titio72/n2k_wind/WindPCB ADC/fabrication/WindPCB_BOM.csv

Designator | Value | Footprint | Quantity | MPN | Manufacturer
C1, C3, C4, C5, C7, C10, C11 | 100nF | Capacitor_SMD:C_0805_2012Metric | 7 | CC0805KRX7R9BB104 | Yageo
C2 | 1uF | Capacitor_SMD:C_0805_2012Metric | 1 | CC0805KRX7R7BB105 | Yageo
C6 | 330uF 25V | Capacitor_SMD:CP_Elec_8x10 | 1 | EEE-FK1E331P | Panasonic
C8 | 22nF | Capacitor_SMD:C_0805_2012Metric | 1 | CC0805KRX7R9BB223 | Yageo
C9 | 10uF | Capacitor_Tantalum_SMD:CP_EIA-3216-18_Kemet-A | 1 | T491A106K010AT | Kemet
C12 | 10uF | Capacitor_SMD:C_0805_2012Metric | 1 | CL21A106KOQNNNE | Samsung Electro-Mechanics
D1 | LED_RED | LED_SMD:LED_0805_2012Metric | 1 | 150080RS75000 | Wurth Elektronik
D2 | NUP2105L | Package_TO_SOT_SMD:SOT-23 | 1 | NUP2105LT1G | onsemi
F1 | 250mA | Fuse:Fuse_Littelfuse-NANO2-451_453 | 1 | 0454.250MR | Littelfuse
R1 | 3K3 | Resistor_SMD:R_0805_2012Metric | 1 | RC0805FR-073K3L | Yageo
R2, R3, R5, R6, R8 | 4K7 | Resistor_SMD:R_0805_2012Metric | 5 | RC0805FR-074K7L | Yageo
R4 | 220 | Resistor_SMD:R_0805_2012Metric | 1 | RC0805FR-07220RL | Yageo
R7 | 120 | Resistor_SMD:R_0805_2012Metric | 1 | RC0805FR-07120RL | Yageo
R9 | 10K | Resistor_SMD:R_0805_2012Metric | 1 | RC0805FR-0710KL | Yageo
R12 | 2K2 | Resistor_SMD:R_0805_2012Metric | 1 | RC0805FR-072K2L | Yageo
U1 | 74AHC1G14 | Package_TO_SOT_SMD:SOT-23-5_HandSoldering | 1 | SN74AHC1G14DBVR | Texas Instruments
U2 | MCP2562-E-SN | Package_SO:SOIC-8_3.9x4.9mm_P1.27mm | 1 | MCP2562-E/SN | Microchip
U5 | UA78M05CDCYR | Package_TO_SOT_SMD:SOT-223-3_TabPin2 | 1 | UA78M05CDCYR | Texas Instruments
U6 | UA78M08CDCYR | Package_TO_SOT_SMD:SOT-223-3_TabPin2 | 1 | UA78M08CDCYR | Texas Instruments
U7 | MCP3202 | Package_SO:SOIC-8_3.9x4.9mm_P1.27mm | 1 | MCP3202-CI/SN | Microchip
U9, U10, U11 | LM66100DCK | Package_TO_SOT_SMD:SOT-363_SC-70-6 | 3 | LM66100DCKR | Texas Instruments
