titio72/n2k_wind/WindPCB ADC/WindPCB.kicad_pcb

## KiCad design WindPCB ADC/WindPCB.kicad_pcb (2026-11-12)

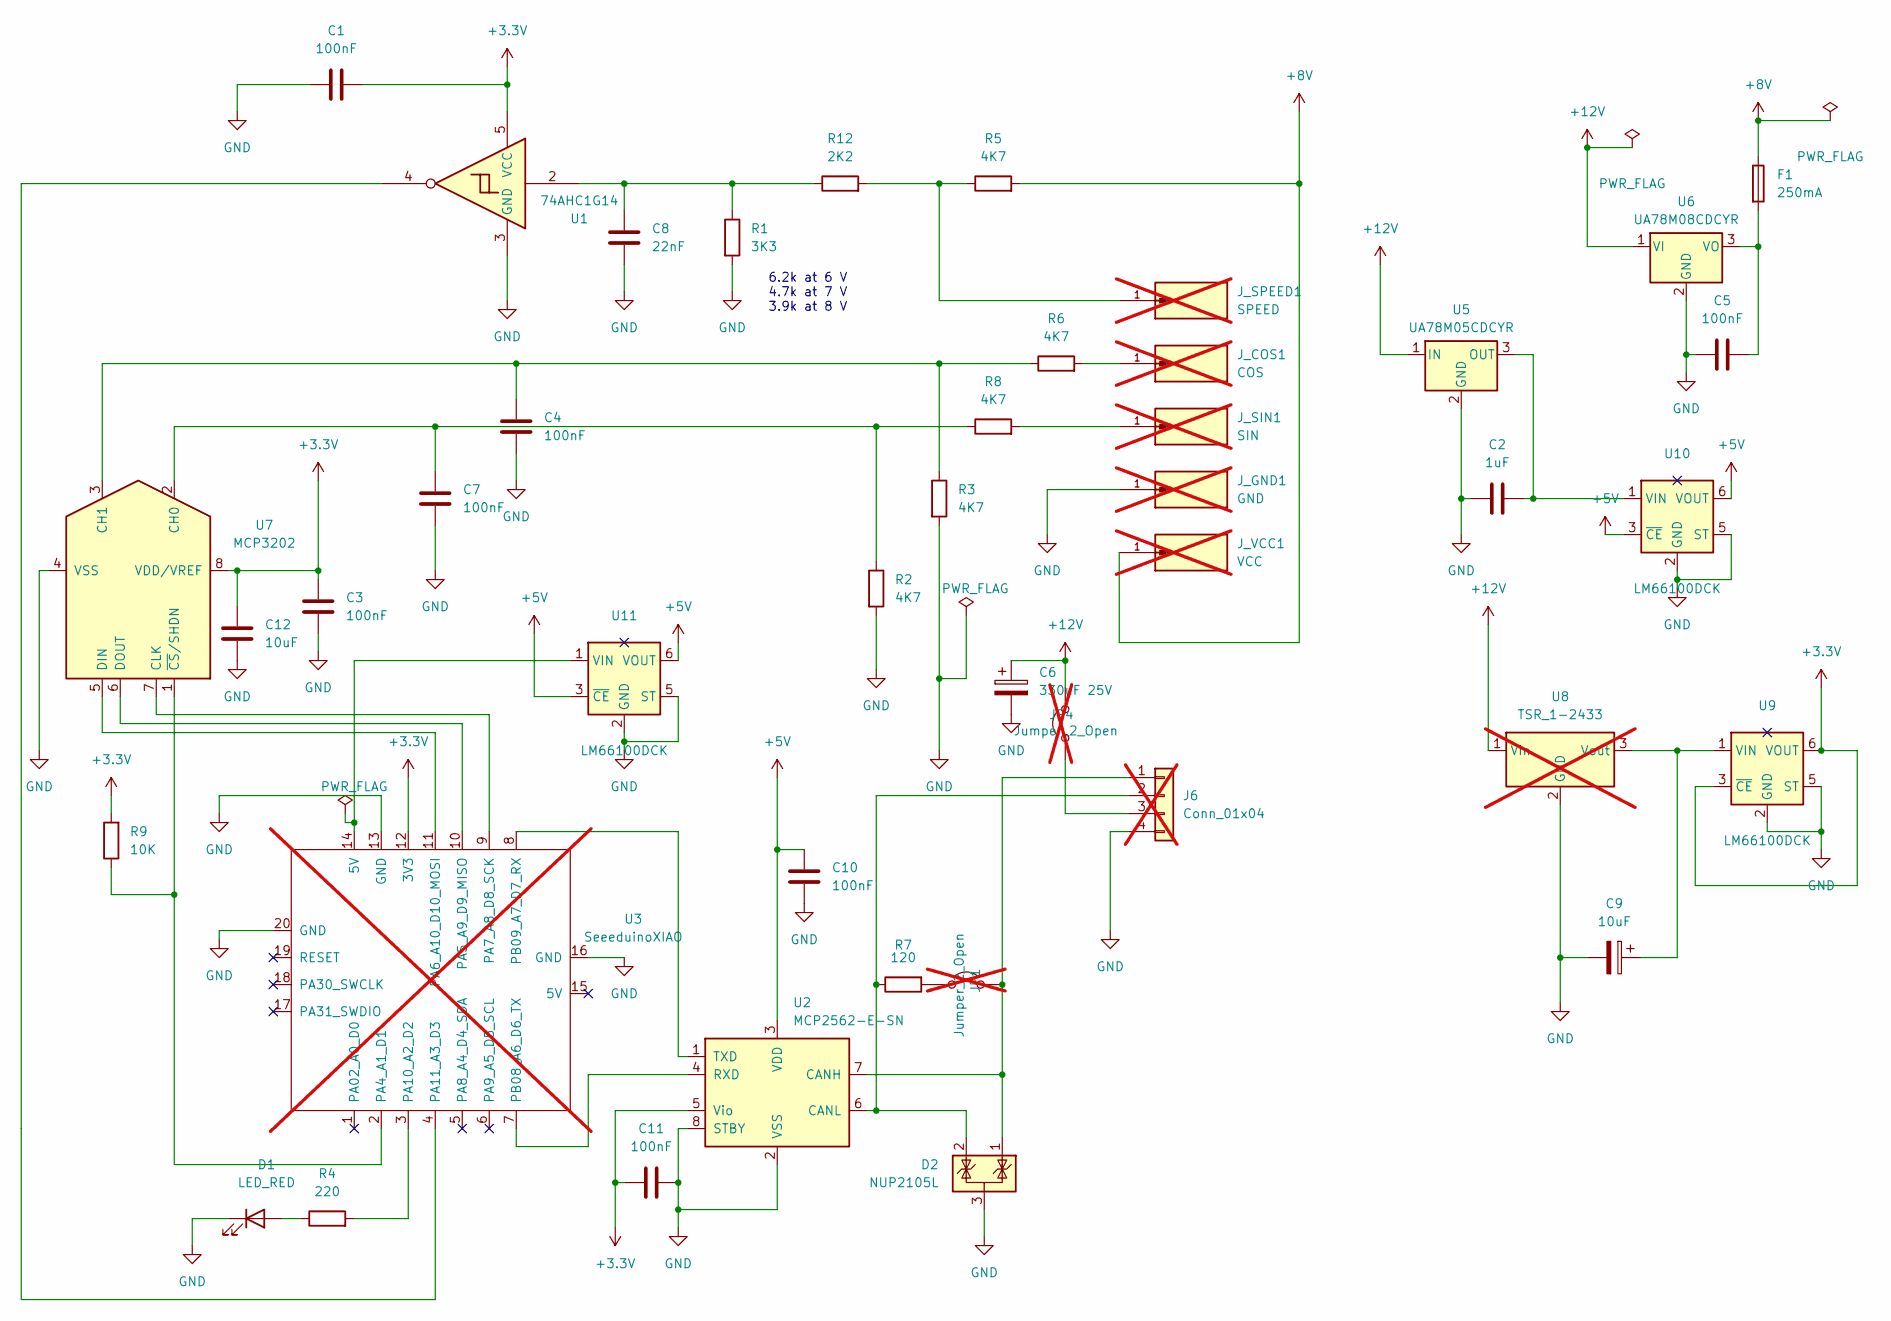
[picture p1: schematic WindPCB.kicad_sch]

Parts:
C1, C3, C4, C5, C7, C10, C11: 100nF; C_0805_2012Metric; MPN CC0805KRX7R9BB104
C2: 1uF; C_0805_2012Metric; MPN CC0805KRX7R7BB105
C6: 330uF 25V; CP_Elec_8x10; MPN EEE-FK1E331P
C8: 22nF; C_0805_2012Metric; MPN CC0805KRX7R9BB223
C9: 10uF; CP_EIA-3216-18_Kemet-A; MPN T491A106K010AT
C12: 10uF; C_0805_2012Metric; MPN CL21A106KOQNNNE
D1: LED_RED; LED_0805_2012Metric; MPN 150080RS75000
D2: NUP2105L; SOT-23; MPN NUP2105LT1G
F1: 250mA; Fuse_Littelfuse-NANO2-451_453; MPN 0454.250MR
J6: Conn_01x04; JST_EH_B4B-EH-A_1x04_P2.50mm_Vertical; not fitted
JP1, JP4: Jumper_2_Open; PinHeader_1x02_P2.54mm_Vertical; not fitted
J_COS1: COS; KEYSTONE_1267; PARTREV D; not fitted
J_GND1: GND; KEYSTONE_1267; PARTREV D; not fitted
J_SIN1: SIN; KEYSTONE_1267; PARTREV D; not fitted
J_SPEED1: SPEED; KEYSTONE_1267; PARTREV D; not fitted
J_VCC1: VCC; KEYSTONE_1267; PARTREV D; not fitted
R1: 3K3; R_0805_2012Metric; MPN RC0805FR-073K3L
R2, R3, R5, R6, R8: 4K7; R_0805_2012Metric; MPN RC0805FR-074K7L
R4: 220; R_0805_2012Metric; MPN RC0805FR-07220RL
R7: 120; R_0805_2012Metric; MPN RC0805FR-07120RL
R9: 10K; R_0805_2012Metric; MPN RC0805FR-0710KL
R12: 2K2; R_0805_2012Metric; MPN RC0805FR-072K2L
U1: 74AHC1G14; SOT-23-5_HandSoldering; MPN SN74AHC1G14DBVR
U2: MCP2562-E-SN; SOIC-8_3.9x4.9mm_P1.27mm; MPN MCP2562-E/SN
U3: SeeeduinoXIAO; Seeeduino XIAO-MOUDLE14P-2.54-21X17.8MM_1; not fitted
U5: UA78M05CDCYR; SOT-223-3_TabPin2; MPN UA78M05CDCYR
U6: UA78M08CDCYR; SOT-223-3_TabPin2; MPN UA78M08CDCYR
U7: MCP3202; SOIC-8_3.9x4.9mm_P1.27mm; MPN MCP3202-CI/SN
U8: TSR_1-2433; Converter_DCDC_TRACO_TSR-1_THT; MPN TSR 1-2433; not fitted
U9, U10, U11: LM66100DCK; SOT-363_SC-70-6; MPN LM66100DCKR

Connections:
+3.3V: C1.1, C3.1, C11.1, C12.1, R9.2, U1.5 (VCC), U2.5 (Vio), U3.12 (3V3), U7.8 (VDD/VREF), U9.3 (~CE), U9.6 (VOUT)
+5V: C10.1, U2.3 (VDD), U10.3 (~CE), U10.6 (VOUT), U11.3 (~CE), U11.6 (VOUT)
+8V: F1.1, J_VCC1.1, R5.2
+12V: C6.1, JP4.2 (B), U5.1 (IN), U6.1 (VI), U8.1 (Vin)
GND: C1.2, C2.1, C3.2, C4.2, C5.1, C6.2, C7.2, C8.2, C9.2, C10.2, C11.2, C12.2, D1.1 (K), D2.3 (A), J6.4, J_GND1.1, R1.2, R2.2, R3.2, U1.3 (GND), U2.2 (VSS), U2.8 (STBY), U3.13 (GND), U3.16 (GND), U3.20 (GND), U5.2 (GND), U6.2 (GND), U7.4 (VSS), U8.2 (GND), U9.2 (GND), U9.5 (ST), U10.2 (GND), U10.5 (ST), U11.2 (GND), U11.5 (ST)
unnamed: C8.1, R1.1, R12.1, U1.2
unnamed: D1.2 (A), R4.1
unnamed: D2.1 (K), J6.1, JP1.2 (B), U2.7 (CANH)
unnamed: D2.2 (K), J6.2, R7.1, U2.6 (CANL)
unnamed: J6.3, JP4.1 (A)
unnamed: JP1.1 (A), R7.2
unnamed: J_COS1.1, R6.2
unnamed: J_SIN1.1, R8.2
unnamed: J_SPEED1.1, R5.1, R12.2
unnamed: U2.4 (RXD), U3.7 (PB08_A6_D6_TX)
unnamed: U2.1 (TXD), U3.8 (PB09_A7_D7_RX)
unnamed: R9.1, U3.2 (PA4_A1_D1), U7.1 (~CS/SHDN)
unnamed: U3.10 (PA5_A9_D9_MISO), U7.6 (DOUT)
unnamed: U3.11 (PA6_A10_D10_MOSI), U7.5 (DIN)
unnamed: U3.9 (PA7_A8_D8_SCK), U7.7 (CLK)
unnamed: R4.2, U3.3 (PA10_A2_D2)
unnamed: U1.4, U3.4 (PA11_A3_D3)
unnamed: C5.2, F1.2, U6.3 (VO)
unnamed: C7.1, R2.1, R8.1, U7.2 (CH0)
unnamed: C4.1, R3.1, R6.1, U7.3 (CH1)
unnamed: C9.1, U8.3 (Vout), U9.1 (VIN)
unnamed: C2.2, U5.3 (OUT), U10.1 (VIN)
unnamed: U3.14 (5V), U11.1 (VIN)

Notes on the sheet:
6.2k at 6 V 4.7k at 7 V 3.9k at 8 V

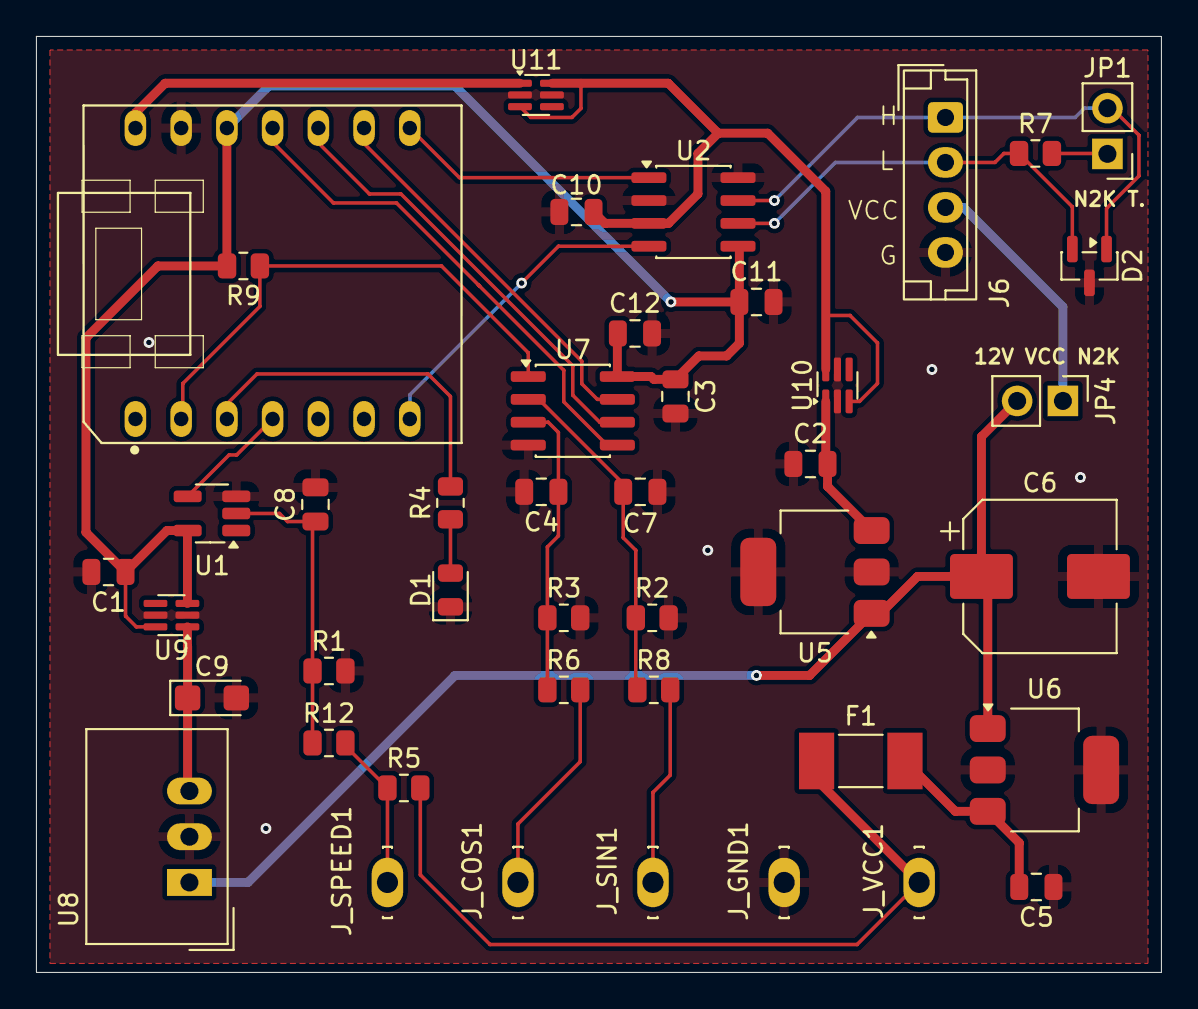
[picture p2: board WindPCB ADC/WindPCB.kicad_pcb from above]

Board: 2 copper layers, 62.5 x 52.0 mm, 43 parts (0 on the bottom side), 28 nets.
