titio72/n2k_wind/WindPCB/WindPCB.kicad_pcb

## KiCad design WindPCB/WindPCB.kicad_pcb (2026-10-11)

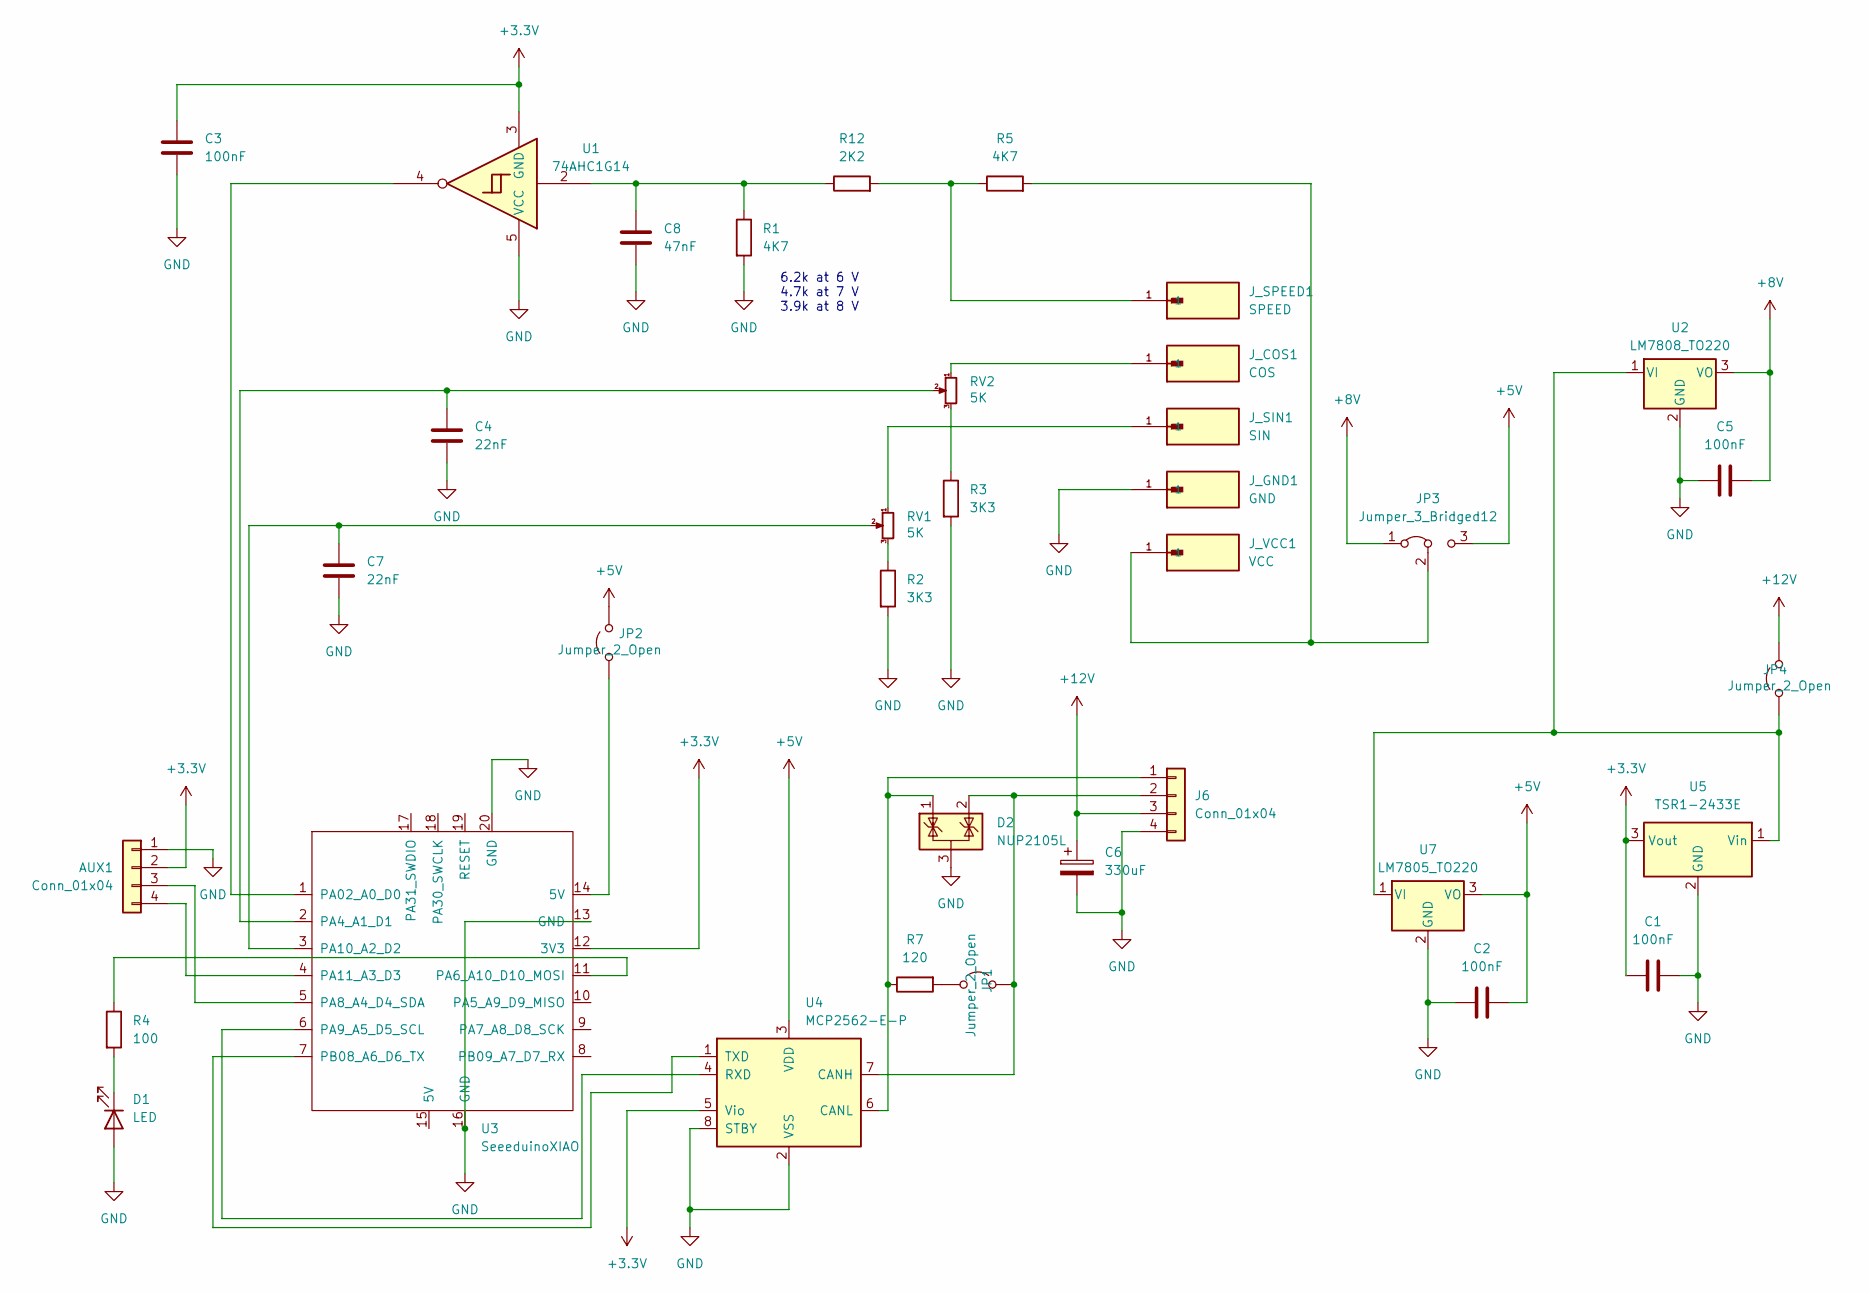
[picture p3: schematic WindPCB.kicad_sch]

Parts:
AUX1: Conn_01x04; JST_EH_B4B-EH-A_1x04_P2.50mm_Vertical
C1, C2, C3, C5: 100nF; C_Disc_D6.0mm_W2.5mm_P5.00mm
C4, C7: 22nF; C_Disc_D6.0mm_W2.5mm_P5.00mm
C6: 330uF; CP_Radial_D6.3mm_P2.50mm
C8: 47nF; C_Disc_D6.0mm_W2.5mm_P5.00mm
D1: LED; LED_D3.0mm
D2: NUP2105L; SOT-23
J6: Conn_01x04; JST_EH_B4B-EH-A_1x04_P2.50mm_Vertical
JP1, JP2, JP4: Jumper_2_Open; PinHeader_1x02_P2.54mm_Vertical
JP3: Jumper_3_Bridged12; PinHeader_1x03_P2.54mm_Vertical
J_COS1: COS; KEYSTONE_1267; PARTREV D
J_GND1: GND; KEYSTONE_1267; PARTREV D
J_SIN1: SIN; KEYSTONE_1267; PARTREV D
J_SPEED1: SPEED; KEYSTONE_1267; PARTREV D
J_VCC1: VCC; KEYSTONE_1267; PARTREV D
R1, R5: 4K7; R_Axial_DIN0204_L3.6mm_D1.6mm_P7.62mm_Horizontal
R2, R3: 3K3; R_Axial_DIN0204_L3.6mm_D1.6mm_P7.62mm_Horizontal
R4: 100; R_Axial_DIN0204_L3.6mm_D1.6mm_P7.62mm_Horizontal
R7: 120; R_Axial_DIN0204_L3.6mm_D1.6mm_P7.62mm_Horizontal
R12: 2K2; R_Axial_DIN0204_L3.6mm_D1.6mm_P7.62mm_Horizontal
RV1, RV2: 5K; Potentiometer_Bourns_3296W_Vertical
U1: 74AHC1G14; SOT-23-5_HandSoldering
U2: LM7808_TO220; TO-220-3_Vertical
U3: SeeeduinoXIAO; Seeeduino XIAO-MOUDLE14P-2.54-21X17.8MM_1
U4: MCP2562-E-P; DIP-8_W7.62mm
U5: TSR1-2433E; Converter_DCDC_TRACO_TSR-1_THT
U7: LM7805_TO220; TO-220-3_Vertical

Connections:
+3.3V: AUX1.2, C1.2, C3.1, U1.3 (GND), U3.12 (3V3), U4.5 (Vio), U5.3 (Vout)
+5V: C2.1, JP2.2 (B), JP3.3 (B), U4.3 (VDD), U7.3 (VO)
+8V: C5.1, JP3.1 (A), U2.3 (VO)
+12V: C6.1, J6.3, JP4.2 (B)
GND: AUX1.1, C1.1, C2.2, C3.2, C4.2, C5.2, C6.2, C7.2, C8.2, D1.2 (A), D2.3 (A), J6.4, J_GND1.1, R1.2, R2.2, R3.2, U1.5 (VCC), U2.2 (GND), U3.13 (GND), U3.16 (GND), U3.20 (GND), U4.2 (VSS), U4.8 (STBY), U5.2 (GND), U7.2 (GND)
unnamed: AUX1.3, U3.5 (PA8_A4_D4_SDA)
unnamed: AUX1.4, U3.4 (PA11_A3_D3)
unnamed: C8.1, R1.1, R12.1, U1.2
unnamed: D1.1 (K), R4.2
unnamed: D2.1 (K), J6.1, R7.1, U4.6 (CANL)
unnamed: D2.2 (K), J6.2, JP1.2 (B), U4.7 (CANH)
unnamed: JP1.1 (A), R7.2
unnamed: JP2.1 (A), U3.14 (5V)
unnamed: JP3.2 (C), J_VCC1.1, R5.2
unnamed: JP4.1 (A), U2.1 (VI), U5.1 (Vin), U7.1 (VI)
unnamed: J_COS1.1, RV2.1
unnamed: J_SIN1.1, RV1.1
unnamed: J_SPEED1.1, R5.1, R12.2
unnamed: R2.1, RV1.3
unnamed: R3.1, RV2.3
unnamed: U1.4, U3.1 (PA02_A0_D0)
unnamed: C4.1, RV2.2, U3.2 (PA4_A1_D1)
unnamed: R4.1, U3.11 (PA6_A10_D10_MOSI)
unnamed: U3.6 (PA9_A5_D5_SCL), U4.4 (RXD)
unnamed: C7.1, RV1.2, U3.3 (PA10_A2_D2)
unnamed: U3.7 (PB08_A6_D6_TX), U4.1 (TXD)

Notes on the sheet:
6.2k at 6 V 4.7k at 7 V 3.9k at 8 V

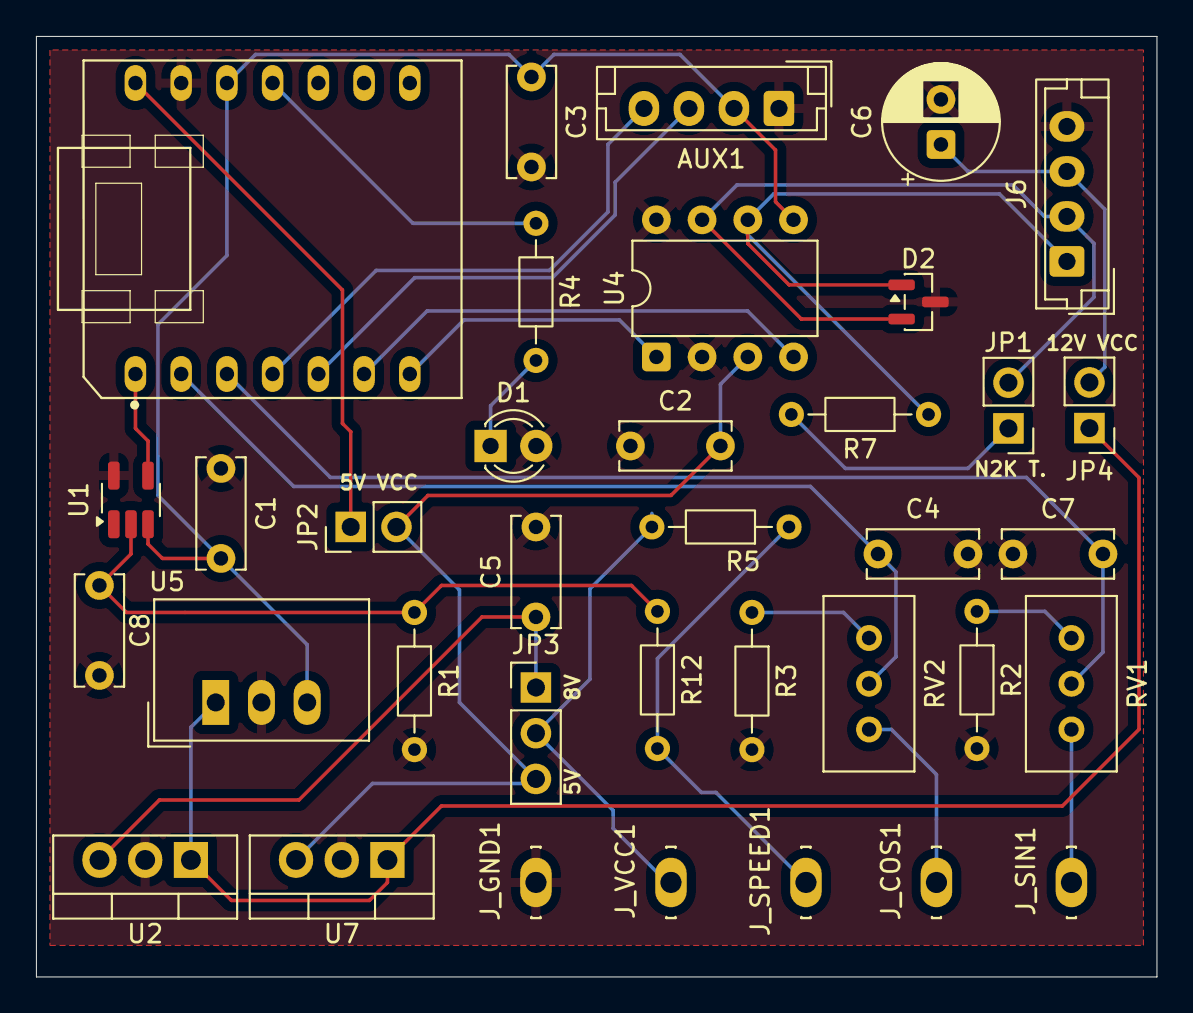
[picture p4: board WindPCB/WindPCB.kicad_pcb from above]

Board: 2 copper layers, 62.2 x 52.2 mm, 36 parts (0 on the bottom side), 26 nets.
