titio72/n2k_wind/src/Constants.h

#ifndef _CONSTANTS_H
#define _CONSTANTS_H

// 12 bit ADC for ESP32, 16 bit ADC for ADS1115
#define MIN_ADC_VALUE 400  // with a power supply of 8V, raymarine specs inidcate a range of 2V-6V, so 400/4096*8V=0.78V is a reasonable threshold
#define MAX_ADC_VALUE 4095
#define MAX_ADC_RANGE 4096 // 12 bit ADC
#define RANGE_DEFAULT_MIN 1024 // default Raymarine specs: 2V over 8V span
#define RANGE_DEFAULT_MAX 3072 // default Raymarine specs: 6V over 8V span
#define RANGE_DEFAULT_VALID 1024 // minimum span to consider a range valid

const uint8_t WIND_ERROR_OFF_CALIBRATION = 0x02; // (bit #1)
const uint8_t WIND_ERROR_NO_SIGNAL = 0x01; // (bit #0)
const uint8_t WIND_ERROR_OK = 0x00;

const uint8_t STW_ERROR_NO_SIGNAL = 0x01; // (bit #0)
const uint8_t STW_ERROR_OK = 0x00;

const uint8_t TEMP_ERROR_NO_SIGNAL = 0x01; // (bit #0)
const uint8_t TEMP_ERROR_OK = 0x00;

#define DEFAULT_WIND_SPEED_SMOOTHING 50 // %
#define DEFAULT_WIND_ANGLE_SMOOTHING 50 // %
#define DEFAULT_STW_SMOOTHING 50 // %
#define DEFAULT_TEMP_SMOOTHING 50 // %

#ifndef DEFAULT_N2K_SOURCE
#define DEFAULT_N2K_SOURCE 21
#endif
#define N2K_MODEL_SERIAL_CODE "0.0.1"
#define N2K_PRODUCT_CODE 101
#define N2K_MODEL_ID "ABWind"
#define N2K_SW_CODE "0.0.1"
#define N2K_MODEL_VERSION "0001"
#define N2K_UNIQUE_NUMBER 2
#define N2K_DEVICEE_FUNCTION 180
#define N2K_DEVICE_CLASS 60
#define N2K_MANIFACTURER_CODE 2046 // just one available...

/*
On ST50:
The vane are r=55mm from the center, so a full round is 2*pi*r
With a frequency of f HZ (there are 4 magnets, so 2 transitions per round, hence the round per seconds are f/2),
it makes a total distance of L=(f/2)*2*pi*r in 1 second, hence the speed in knots is L*3600/1852.
This is assuming that there is no friction - let's assume that the rotation speed is 50% of.
The magic number to convert Hz in Knots is 2*(pi*0.055*2600/1852) = 0.672

On ST60 
Raymarine says that 20Hz (10Hz considering a full revolution) is 20Knots, which would mean a factor of 1.0 instead of 0.672
*/
#define VANE_TYPE_ST50 0
#define VANE_TYPE_ST60 1

#define VANE_TYPE_DEFAULT VANE_TYPE_ST50 // ST50

#define HZ_TO_KNOTS_ST50 0.700 // use 0.673 ~ 0.700 for ST50
#define HZ_TO_KNOTS_ST60 1.000 // use 1.000 for ST60

// Sin and Cos are calculated as moving average over N samples
#define SIN_COS_BUFFER_SIZE 200 // about 0.2s averaging at 1ms rate 

// main loop
#define MAIN_LOOP_PERIOD_LOW_FREQ 250L // (millis) regulates the main loop used to read sensors and interacts with N2K & BLE
#define WIND_N2K_DATA_FREQ 500L // (millis) regulates how frequently send out wind info on the N2K bus
#define STW_N2K_DATA_FREQ 1000L // (millis) regulates how frequently send out speed through water info on the N2K bus
#define CORRECTION_TABLE_FIRST_BROADCAST 5000L // (millis) first PGN 130900 broadcast after boot
#define CORRECTION_TABLE_BROADCAST_PERIOD 60000L // (millis) PGN 130900 repeat period
#define CALIBRATION_SAMPLING_EXCLUSION_PERIOD 10000L // (millis) do not take samples for 10 seconds after restart (sample would be funny)
#define CPU_FREQUENCY 80 // MHz (ESP32 default is 160). 80 is the lower value that makes the device operable
#define SPEED_SENSING_PERIOD_MULTIPLIER 4 // The frequency is collected every N main loops to reduce noise (1 means every loop, 2 every two loops, etc...)

// BLE
#define BLE_DEVICE_UUID "32890585-c6ee-498b-9e7a-044baefb6542"
#define BLE_COMMAND_UUID "c3fe2075-ac6c-40bf-8073-73a110453725"
#define BLE_CONF_UUID "c04a9b9c-3ab6-4cce-9b59-1b582112e693"
#define BLE_WIND_DATA_UUID "003d0cab-70f7-43ac-8ab9-db26466572af"
// Correction table, PGN 130900 payload (10..180 bytes). Read it (long read):
// a notification is cut at MTU-3 = 125 bytes, so don't subscribe.
#define BLE_TABLE_UUID "b0ff19bd-7c2d-4215-8cc0-2a6db52cdf4f"
#define BLE_DEVICE_NAME "Wind"
#define BLE_COMMAND_CHARACTERISTIC_NAME "command"
#define BLE_DATA_CHARACTERISTIC_NAME "data"
#define BLE_CONF_CHARACTERISTIC_NAME "conf"
#define BLE_TABLE_CHARACTERISTIC_NAME "table"
#define BLE_ACTIVITY_TIMEOUT 30000L // (millis) time after which we consider that the connection is dead if no command is received

// The reading gives sin and cos, and sqrt(sin^2+cos^2 )must be equal to 1.0, or close to it. Large differences means that the linearization
// of the sin and cos sensors is off. This define the admissible delta, which essentially mesaure the eccentricity of measure.
#define ELLIPSE_VALIDITY_THRESHOLD 0.2

// admissible value ranges for configuration 
#define SMOOTHING_ALPHA_MIN 0
#define SMOOTHING_ALPHA_MAX 100

#define AUTO_CALIB_THRESHOLD_MIN 50
#define AUTO_CALIB_THRESHOLD_MAX 100
#define AUTO_CALIBRATION_SCORE_THRESHOLD_DEFAULT 0.75 // default threshold to consider a calibration valid

const uint8_t YES = 1;
const uint8_t NO = 0;
#endif
