titio72/n2k_wind/src/CommandHandler.cpp

#include <Log.h>
#include "CommandHandler.h"
#include "DataAndConf.h"
#include "Calibration.h"
#include "BLEWind.h"
#include "WindCorrection.h"
#include "CorrectionPersistence.h"
#include <stdlib.h>
#include <math.h>

struct CommandContext
{
    ConfPersistence &confPersistence;
    configuration &conf;
    Calibration &cal;
    IBLEWind &ble;
    correction_table &table;
    CorrectionPersistence &tablePersistence;
    table_changed_callback on_table_changed;

    bool write_conf()
    {
        return confPersistence.write(conf);
    }

    // Persists the edited copy; only then makes it the table and notifies.
    // On a write failure the table is left as it was.
    CommandResult commit_table(const correction_table &edited)
    {
        if (!tablePersistence.write(edited))
        {
            Log::trace("[CMD] Error writing correction table\n");
            return CommandResult::WRITE_ERROR;
        }
        table = edited;
        if (on_table_changed)
            on_table_changed();
        return CommandResult::SUCCESS;
    }
};

/*
The first char of the input is the "command", so there can be only 256 (plenty).
The following characters are a null terminated string and they contains the payload (if any).
Easy to parse and enough for the purpose.
*/
typedef CommandResult (*wind_command)(CommandContext &ctx, const char *command_value);
wind_command commands[256];

#pragma region commands
CommandResult apply_calibration(Range &sin, Range& cos, calibration_callback cback)
{
    if (cback && cback(sin, cos))
    {
        return CommandResult::SUCCESS;
    }
    else
    {
        Log::trace("[CMD] Manual calibration failed.\n");
        return CommandResult::INTERNAL_ERROR;
    }
}

CommandResult command_vane_type(CommandContext &ctx, const char* command_value)
{
    Log::trace("[CMD] Setting vane type {%s}\n", command_value);
    int32_t vane = 0;
    if (parse_value(vane, command_value, VANE_TYPE_ST60, VANE_TYPE_ST50))
    {
        Log::trace("[CMD] New vane type {%s}\n", vane==VANE_TYPE_ST50?"ST50":"ST60");
        ctx.conf.vane_type = vane;
        return ctx.write_conf() ? CommandResult::SUCCESS : CommandResult::WRITE_ERROR;
    }
    Log::trace("[CMD] Invalid vane type\n");
    return CommandResult::INVALID_FORMAT;
}

CommandResult command_heartbeat(CommandContext &ctx, const char* command_value)
{
    // do nothing
    return CommandResult::SUCCESS;
}

CommandResult command_set_speed_adj(CommandContext &ctx, const char *command_value)
{
    Log::trace("[CMD] Setting speed adjustment {%s}\n", command_value);
    int32_t adj = atoi(command_value);
    if (parse_value(adj, command_value, 255, 0))
    {
        Log::trace("[CMD] New speed adjustment {%d}\n", adj);
        ctx.conf.speed_adjustment = adj;
        return ctx.write_conf() ? CommandResult::SUCCESS : CommandResult::WRITE_ERROR;
    }
    Log::trace("[CMD] Invalid speed adjustment\n");
    return CommandResult::INVALID_FORMAT;
}

CommandResult command_set_offset(CommandContext &ctx, const char *command_value)
{
    Log::trace("[CMD] Setting offset {%s}\n", command_value);
    int32_t offset = 0;
    if (parse_value(offset, command_value, 360, -360))
    {
        Log::trace("[CMD] New offset {%d}\n", offset);
        ctx.conf.offset = offset;
        return ctx.write_conf() ? CommandResult::SUCCESS : CommandResult::WRITE_ERROR;
    }
    Log::trace("[CMD] Invalid offset\n");
    return CommandResult::INVALID_FORMAT;
}

CommandResult command_set_calibration(CommandContext &ctx, const char *command_value)
{
    Log::trace("[CMD] Setting manual calibration {%s}\n", command_value);
    int i_tok = 0;
    int32_t vv[] = {-1, -1, -1, -1};
    bool do_write = false;
    char s[256];
    strncpy(s, command_value, sizeof(s));
    char *t, *p;
    for (t = mystrtok(&p, s, '|'); t && i_tok < 4; t = mystrtok(&p, 0, '|'))
    {
        if (strlen(t))
        {
            parse_value(vv[i_tok], t, MAX_ADC_VALUE);
        }
        i_tok++;
    }
    Log::trace("[CMD] Read manual cal values {%d %d %d %d}\n", vv[0], vv[1], vv[2], vv[3]);
    if (vv[0] >= 0 && vv[1] >= 0 && vv[2] >= 0 && vv[3] >= 0)
    {
        Range s_range((uint16_t)vv[0], (uint16_t)vv[1], RANGE_DEFAULT_VALID);
        Range c_range((uint16_t)vv[2], (uint16_t)vv[3], RANGE_DEFAULT_VALID);
        return apply_calibration(s_range, c_range, ctx.cal.get_callback());
    }
    else
    {
        Log::trace("[CMD] Manual calibration invalid\n");
        return CommandResult::INVALID_FORMAT;
    }
}

CommandResult command_finalize_calibration(CommandContext &ctx, const char *command_value)
{
    Log::trace("[CMD] finalize calibration\n");
    ctx.cal.apply_calibration();
    return CommandResult::SUCCESS;
}

CommandResult command_factory_reset(CommandContext &ctx, const char *command_value)
{
    Log::trace("[CMD] Reset calibration to default\n");
    ctx.conf.reset();
    if (!ctx.write_conf())
        return CommandResult::WRITE_ERROR;
    correction_table empty;
    correction_clear(empty);
    return ctx.commit_table(empty);
}

CommandResult command_abort_calibration(CommandContext &ctx, const char *command_value)
{
    Log::trace("[CMD] Abort calibration\n");
    ctx.cal.reset();
    return CommandResult::SUCCESS;
}

CommandResult command_set_speed_smoothing(CommandContext &ctx, const char *command_value)
{
    Log::trace("[CAL] Setting speed smoothing {%s}\n", command_value);
    int32_t smoothing = 0;
    if (parse_value(smoothing, command_value, SMOOTHING_ALPHA_MAX, SMOOTHING_ALPHA_MIN))
    {
        ctx.conf.speed_smoothing = smoothing;
        Log::trace("[CAL] New speed smoothing {%d} alpha {%.2f}\n", smoothing, ctx.conf.get_speed_smoothing_factor());
        return ctx.write_conf() ? CommandResult::SUCCESS : CommandResult::WRITE_ERROR;
    }
    Log::trace("[CAL] Invalid speed smoothing\n");
    return CommandResult::INVALID_FORMAT;
}

CommandResult command_set_angle_smoothing(CommandContext &ctx, const char *command_value)
{
    Log::trace("[CAL] Setting angle smoothing {%s}\n", command_value);
    int32_t smoothing = 0;
    if (parse_value(smoothing, command_value, SMOOTHING_ALPHA_MAX, SMOOTHING_ALPHA_MIN))
    {
        ctx.conf.angle_smoothing = smoothing;
        Log::trace("[CAL] New angle smoothing {%d} alpha {%.2f}\n", smoothing, ctx.conf.get_angle_smoothing_factor());
        return ctx.write_conf() ? CommandResult::SUCCESS : CommandResult::WRITE_ERROR;
    }
    Log::trace("[CAL] Invalid angle smoothing\n");
    return CommandResult::INVALID_FORMAT;
}

CommandResult command_set_auto_calibration_threshold(CommandContext &ctx, const char *command_value)
{
    Log::trace("[CAL] Setting auto calibration threshold {%s}\n", command_value);
    int32_t threshold = 0;
    if (parse_value(threshold, command_value, AUTO_CALIB_THRESHOLD_MAX, AUTO_CALIB_THRESHOLD_MIN))
    {
        ctx.conf.calibration_score_threshold = threshold;
        Log::trace("[CAL] New auto calibration threshold {%d} {%.2f}\n", threshold, ctx.conf.get_calibration_threshold_factor());
        return ctx.write_conf() ? CommandResult::SUCCESS : CommandResult::WRITE_ERROR;
    }
    else
    {
        Log::trace("[CAL] Invalid auto calibration threshold\n");
        return CommandResult::INVALID_FORMAT;
    }
}

CommandResult command_toggle_autocalib(CommandContext &ctx, const char *command_value)
{
    Log::trace("[CAL] Toggle auto calibration {%s}\n", ctx.cal.is_enabled() ? "OFF" : "ON");
    if (ctx.cal.is_enabled())
    {
        ctx.conf.auto_cal = 0;
        ctx.cal.enable(false);
    }
    else
    {
        ctx.conf.auto_cal = 1;
        ctx.cal.reset();
        ctx.cal.enable(true);
    }
    return ctx.write_conf() ? CommandResult::SUCCESS : CommandResult::WRITE_ERROR;
}

CommandResult command_toggle_debug(CommandContext &ctx, const char *command_value)
{
    Log::trace("[CAL] Toggle debug info on USB {%s}\n", ctx.conf.usb_tracing ? "OFF" : "ON");
    int32_t d = 0;
    if (parse_value(d, command_value, 1, 0))
    {
        ctx.conf.usb_tracing = d;
        if (ctx.conf.usb_tracing)
        {
            Log::enable();
        }
        else
        {
            Log::disable();
        }
    }
    return ctx.write_conf() ? CommandResult::SUCCESS : CommandResult::WRITE_ERROR;
}

CommandResult command_change_ble_name(CommandContext &ctx, const char *command_value)
{
    Log::trace("[CMD] Changing BLE name to {%s}\n", command_value);
    if (command_value && strlen(command_value) > 0 && strlen(command_value) < 15)
    {
        ctx.conf.set_ble_name(command_value);
        ctx.ble.set_device_name(command_value);
        Log::trace("[CMD] New BLE name {%s}\n", ctx.conf.ble_name);
        return ctx.write_conf() ? CommandResult::SUCCESS : CommandResult::WRITE_ERROR;
    }
    Log::trace("[CMD] Invalid BLE name\n");
    return CommandResult::INVALID_FORMAT;
}

CommandResult command_table_enable(CommandContext &ctx, const char *command_value)
{
    Log::trace("[CMD] Correction table enable {%s}\n", command_value);
    if (command_value == nullptr || command_value[1] != 0 || (command_value[0] != '0' && command_value[0] != '1'))
        return CommandResult::INVALID_FORMAT;
    correction_table edited = ctx.table;
    edited.enabled = (command_value[0] == '1') ? 1 : 0;
    return ctx.commit_table(edited);
}

CommandResult command_table_upsert(CommandContext &ctx, const char *command_value)
{
    Log::trace("[CMD] Correction table upsert {%s}\n", command_value);
    correction_row row;
    if (!parse_correction_row(command_value, row))
        return CommandResult::INVALID_FORMAT;
    correction_table edited = ctx.table;
    if (!correction_upsert(edited, row))
        return CommandResult::OUT_OF_RANGE; // row was valid, so the table is full
    return ctx.commit_table(edited);
}

CommandResult command_table_delete(CommandContext &ctx, const char *command_value)
{
    Log::trace("[CMD] Correction table delete {%s}\n", command_value);
    if (command_value == nullptr || command_value[0] == 0)
        return CommandResult::INVALID_FORMAT;
    char *end = nullptr;
    double tws = strtod(command_value, &end);
    if (end == command_value || *end != 0 || !isfinite(tws))
        return CommandResult::INVALID_FORMAT;
    long tws_units = lround(tws * 10.0);
    if (tws_units < 0 || tws_units > CORRECTION_MAX_TWS)
        return CommandResult::OUT_OF_RANGE;
    correction_table edited = ctx.table;
    if (!correction_delete(edited, (uint16_t)tws_units))
        return CommandResult::OUT_OF_RANGE;
    return ctx.commit_table(edited);
}

CommandResult command_table_clear(CommandContext &ctx, const char *command_value)
{
    Log::trace("[CMD] Correction table clear\n");
    correction_table edited;
    correction_clear(edited);
    return ctx.commit_table(edited);
}

#pragma endregion

CommandHandler::CommandHandler(configuration &c, ConfPersistence &confPersistence, Calibration &cal, IBLEWind &b,
                               correction_table &t, CorrectionPersistence &tp, table_changed_callback cb)
    : confPersistence(confPersistence), conf(c), calibration(cal), ble(b), table(t), tablePersistence(tp), on_table_changed(cb)
{
    memset(commands, 0, sizeof(commands));
    commands['K'] = command_set_speed_adj; // Set speed adj
    commands['O'] = command_set_offset; // Set offset
    commands['S'] = command_set_calibration; // Set manual calibration
    commands['A'] = command_abort_calibration; // Abort calibration
    commands['R'] = command_finalize_calibration; // Finalize calibration
    commands['X'] = command_factory_reset; // Calibration factory reset
    commands['H'] = command_heartbeat; // Heartbeat
    commands['W'] = command_set_speed_smoothing; // change LPF alpha for the speed smoothing
    commands['Q'] = command_set_angle_smoothing; // change LPF alpha for the direction smoothing
    commands['P'] = command_toggle_autocalib; // Start auto calibration
    commands['T'] = command_set_auto_calibration_threshold; // auto calibration threshold
    commands['D'] = command_toggle_debug; // enable/disable USB tracing
    commands['V'] = command_vane_type; // send vane type (0=ST50, 1=ST60)
    commands['N'] = command_change_ble_name; // change BLE device name
    commands['C'] = command_table_enable; // correction table on/off (0/1)
    commands['U'] = command_table_upsert; // correction table: upsert row
    commands['Z'] = command_table_delete; // correction table: delete row by TWS
    commands['Y'] = command_table_clear; // correction table: clear
}

CommandResult CommandHandler::exec_command(const char *value)
{
    if (value && value[0])
    {
        const char command = value[0];
        wind_command cmd = commands[command];
        if (cmd)
        {
            const char *command_value = (value + sizeof(char)); // skip the first char (which is the command code)
            CommandContext ctx = {confPersistence, conf, calibration, ble, table, tablePersistence, on_table_changed};
            CommandResult res = cmd(ctx, command_value);
            return res;
        }
        else
        {
            Log::trace("[CMD] Unrecognized command {%s}\n", value);
            return CommandResult::UNKNOWN_COMMAND;
        }
    }
    else
    {
        return CommandResult::MISSING_INPUT;
    }
}
