titio72/n2k_wind/src/WindDirectionMCP320x.cpp

#ifndef NATIVE
#ifndef NATIVE
#include <Arduino.h>
#endif
#include <math.h>
#include "WindDirectionMCP320x.h"
#include "WindUtil.h"

#include <SPI.h>

#ifndef MCP3202_CS_PIN
#define MCP3202_CS_PIN GPIO_NUM_3 // D1 in Seed esp32-c3
#endif

#ifndef ADC_VREF
#define ADC_VREF    3300     // 3.3V Vref
#endif

#ifndef ADC_CLK
#define ADC_CLK     1000000  // SPI clock 1MHz (MCP3202 @3.3V is rated below 1.6MHz)
#endif

#ifndef MCP3202_SIN_CHANNEL
#define MCP3202_SIN_CHANNEL 0
#endif

#ifndef MCP3202_COS_CHANNEL
#define MCP3202_COS_CHANNEL 1
#endif

#if MCP3202_COS_CHANNEL==0
static const MCP320xTypes::MCP3202::Channel COS_CHANNEL = MCP3202::Channel::SINGLE_0;
#else
static const MCP320xTypes::MCP3202::Channel COS_CHANNEL = MCP3202::Channel::SINGLE_1;
#endif

#if MCP3202_SIN_CHANNEL==0
static const MCP320xTypes::MCP3202::Channel SIN_CHANNEL = MCP3202::Channel::SINGLE_0;
#else
static const MCP320xTypes::MCP3202::Channel SIN_CHANNEL = MCP3202::Channel::SINGLE_1;
#endif

#define SAMPLE_BUFFERING

WindDirectionMCP320x::WindDirectionMCP320x() : ix_buffer_cos(0), ix_buffer_sin(0), sumCos(0), sumSin(0), spiSettings(ADC_CLK, MSBFIRST, SPI_MODE0), adc(ADC_VREF, MCP3202_CS_PIN)
{
    memset(sinBuffer, 0, sizeof(uint16_t) * SIN_COS_BUFFER_SIZE);
    memset(cosBuffer, 0, sizeof(uint16_t) * SIN_COS_BUFFER_SIZE);
}

WindDirectionMCP320x::~WindDirectionMCP320x()
{
}

void inline buffer_it(uint16_t v, uint16_t *buf, uint16_t &ix, double &s, uint16_t &n_samples)
{
    n_samples = std::min(SIN_COS_BUFFER_SIZE, n_samples + 1);
    uint16_t old = buf[ix];
    buf[ix] = v;
    s = s - old + v;
    ix = (ix + 1) % SIN_COS_BUFFER_SIZE;
}

inline bool is_valid_reading(uint16_t reading)
{
    // The typical range is between 1/4 and 3/4 of the total range, hence a minimum of 1024. Below 600, is certainly a bad reading or a disconnected sensor.
    return reading <= MAX_ADC_VALUE && reading>=600; // expand in future...
}

//------------------------

void WindDirectionMCP320x::loop_micros(unsigned long now_micros, uint16_t test_cos_reading, uint16_t test_sin_reading) // this is called from an ISR every 1ms
{
    if (test_sin_reading != UINT16_MAX && test_cos_reading != UINT16_MAX)
    {
        // test purposes
        #ifdef SAMPLE_BUFFERING
        buffer_it(test_sin_reading, sinBuffer, ix_buffer_sin, sumSin, n_samples_sin);
        buffer_it(test_cos_reading, cosBuffer, ix_buffer_cos, sumCos, n_samples_cos);
        #endif
        return;
    }

    #ifndef NATIVE
    #ifdef SAMPLE_BUFFERING
    SPI.beginTransaction(spiSettings);
    uint16_t i_sin = adc.read(SIN_CHANNEL);
    uint16_t i_cos = adc.read(COS_CHANNEL);
    SPI.endTransaction();
    buffer_it(i_sin, sinBuffer, ix_buffer_sin, sumSin, n_samples_sin);
    buffer_it(i_cos, cosBuffer, ix_buffer_cos, sumCos, n_samples_cos);
    #endif
    #endif
}

void WindDirectionMCP320x::setup()
{
    #ifndef NATIVE

    // configure PIN mode
    pinMode(MCP3202_CS_PIN, OUTPUT);

    // set initial PIN state
    digitalWrite(MCP3202_CS_PIN, HIGH);

    // initialize SPI interface for MCP3202
    SPI.begin();

    // for Rayarine, the output is 2V-6V, and we have a x2 divider, bringing the range to 1V-3V
    // The reference voltage is 3.3V, so we can use the default gain of 1x, which gives us a range of 0-4.096V, which is sufficient for our needs.

    SPI.beginTransaction(spiSettings);
    adc.calibrate(MCP3202::Channel::SINGLE_0);
    adc.calibrate(MCP3202::Channel::SINGLE_1);
    SPI.endTransaction();
    #endif
}

void WindDirectionMCP320x::read_data(wind_data &wd, configuration &conf, unsigned long milliseconds)
{
    #ifdef SAMPLE_BUFFERING
    if (n_samples_cos == 0) return; // no data yet
    wd.i_cos = (uint16_t)round(sumCos / n_samples_cos);
    wd.i_sin = (uint16_t)round(sumSin / n_samples_sin);
    #else
    SPI.beginTransaction(spiSettings);
    wd.i_sin = adc.read(SIN_CHANNEL);
    wd.i_cos = adc.read(COS_CHANNEL);
    SPI.endTransaction();
    #endif
    if (!is_valid_reading(wd.i_sin) || !is_valid_reading(wd.i_cos))
    {
        wd.ellipse = NAN;
        wd.angle = NAN;
        wd.smooth_angle = NAN;
        set_error(wd.angle_error, true, WIND_ERROR_NO_SIGNAL);
    }
    else
    {
        double v_sin = sin_calib_range.to_analog(-1, 1, wd.i_sin);
        double v_cos = cos_calib_range.to_analog(-1, 1, wd.i_cos);
        wd.ellipse = sqrt(v_sin * v_sin + v_cos * v_cos);
        wd.angle = norm_deg(to_degrees(atan2(v_sin, v_cos)));
        wd.smooth_angle = lpf_angle(wd.smooth_angle, wd.angle, conf.get_angle_smoothing_factor());
        set_error(wd.angle_error, false, WIND_ERROR_NO_SIGNAL);
    }
    last_read_time = milliseconds;
}

void WindDirectionMCP320x::apply_configuration(configuration &conf)
{
    sin_calib_range = conf.sin_range;
    cos_calib_range = conf.cos_range;
}
#endif // NATIVE
