titio72/n2k_wind/src/DataAndConf.h

#ifndef _CONF_H
#define _CONF_H

#include <stdint.h>
#include <math.h>
#include "WindUtil.h"
#include "WindCorrection.h"

#define CONF_SERIAL 12

struct configuration
{
public:
  char serial;
  Range sin_range;
  Range cos_range;
  int16_t offset;
  uint8_t speed_smoothing;
  uint8_t angle_smoothing;
  uint8_t speed_adjustment;
  uint8_t n2k_source;
  uint8_t auto_cal;
  uint8_t calibration_score_threshold;
  uint8_t usb_tracing;
  uint8_t vane_type;
  char ble_name[16];
  
  configuration();

  double get_angle_smoothing_factor() const;

  double get_speed_smoothing_factor() const;

  double get_calibration_threshold_factor() const;

  double get_speed_adjustement() const;

  void set_ble_name(const char *name);

  void reset();


};

// One EEPROM blob holds the configuration and, after it, the correction
// table block (magic + version + table). On ESP32 commit() writes exactly
// begin(size) bytes, so every writer must open it with this total size.
#define EEPROM_TOTAL_SIZE (sizeof(configuration) + 2 + sizeof(correction_table))

class ConfPersistence
{
public:
  virtual ~ConfPersistence() {}
  virtual bool write(configuration &conf);
  virtual bool read(configuration &conf, int *error_code = nullptr);
};

struct wind_data
{
  // angle data
  double angle = 0.0;
  double smooth_angle = 0.0;
  double ellipse = 1.0;
  uint8_t angle_error = WIND_ERROR_NO_SIGNAL;
  uint16_t i_sin = 0;
  uint16_t i_cos = 0;

  // speed data
  double speed = 0.0;
  double frequency = 0.0;
  uint8_t speed_error = WIND_ERROR_NO_SIGNAL;
};

// What the sensor did to the last N2K wind sample (BLE diagnostics).
struct correction_status
{
  uint32_t table_id = 0;
  uint8_t enabled = 0;
  uint8_t corrected = 0;
  double awa = NAN; // sent AWA, deg [0,360)
  double aws = NAN; // sent AWS, kn
};

struct all_data
{
  // system data
  uint8_t n2k_err = 1;
  unsigned long heap = 0;

  wind_data wind;
  correction_status correction;

  double get_out_angle(const configuration &conf) const
  {
    return norm_deg(wind.smooth_angle + conf.offset);
  }
};
#endif
