titio72/n2k_wind/(commit log)

2025-10-23 Lot of good stuff
    [WindPCB.kicad_sch]
2025-10-30 Added support to auto calibration
2025-11-01 Changed analog pins
    [WindPCB.kicad_sch]
2025-11-03 Introduced the concept of calibration score
2025-11-11 Refactoring - added better support for seeed studio esp32
2025-11-14 Moved BLE constants to Cnstants.h Added delay before starting to collect samples for calibration
2025-11-17 Moved wind_data structure to new module DataAndConf Extended Range object capabilities (expand range & ADC conversion) Eliminated dead code in WindSpeed Minor refactoring of WindDirection: now the Si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
    [CommandHandler.cpp, CommandHandler.h, Constants.h, DataAndConf.cpp, DataAndConf.h, LedDriver.cpp, N2kWind.hpp, Wind360.cpp]
2025-11-18 Vane type is now configurable at runtime and part of the configuration. The code to apply a calibration is now centralized (the CommandHandler "borrows" the callback function from the AutoCalibration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
    [WindPCB.kicad_sch]
2025-11-23 Removed not used code. Dropeed ADS1115 (not advantages). Added suppoer to change teh device name (BLE). Moved N2K info to Constants. Other minor changes and improvements.
    [WindPCB.kicad_pcb, WindPCB.kicad_sch]
2026-02-16 Fixed bug where a x2 multplier was used to calculate wind speed. Working on using ADS1115 instead of ESP32 internal ADC.
    [Constants.h, N2kWind.hpp, WindSpeed.cpp, WindSpeed.h, main.cpp]
2026-03-03 Dropped experimental ADS1115 and fixed bug causing frequency to be reported as half of teh real one
    [BLESerializer.cpp, CommandHandler.cpp, DataAndConf.cpp, DataAndConf.h, WindSpeed.cpp, main.cpp]
2026-10-11 Work in progress: use a MCP3202 instead of the the ESP32 ADC
2026-10-11 Reduiced the size of the PCB (v2)
2026-10-29 Ignore nmea.log and stop tracking .vscode; switch seeed 1.0 upload port to ttyACM0
2026-11-09 Lower MCP3202 SPI clock to 1MHz and update BoM (C4/C7 100nF, add C12)
2026-11-09 Update WindPCB ADC KiCad design, libraries and datasheets; adjust CAN/LED pins in platformio.ini
2026-11-10 Add power supply specification for WindPCB ADC
    Document rails, LM66100 ideal-diode OR-ing and required behaviour for
    NMEA2000-only, USB-only and combined power, plus open points and a
    bring-up checklist.
2026-11-12 WindPCB v2.0: move speed input to D3/GPIO5, fix capacitor MPNs
    - Route the speed input (U1 output) to XIAO D3 (GPIO5) instead of D0
    (GPIO2): GPIO2 is an ESP32-C3 strapping pin that U1 could hold low at
    reset, preventing boot. Set SPEED_PIN=GPIO_NUM_5 in the seeed_2_0 env.
    - C12 on U7 VDD/VREF changed from 10nF to 10uF (CL21A106KOQNNNE).
    - Fix MPNs that did not match values: C2 1uF (CC0805KRX7R7BB105),
    C4/C7 100nF (CC0805KRX7R9BB104).
    - Re-export the BoM.
2026-11-13 Add per-sample corrected output decision
2026-11-13 Wire correction table onto the N2K bus
2026-11-13 Fix review findings: STW RX starvation, AWS=0, folding tables
    - Poll the N2K bus every main-loop pass (TWAI RX queue holds 5 frames)
    - Pass samples through when AWS < 0.1 kn
    - Reject tables whose correction slopes exceed 0.5
